taninjs/ESP32-STPM10/PCBs/Infrared/Infrared.step

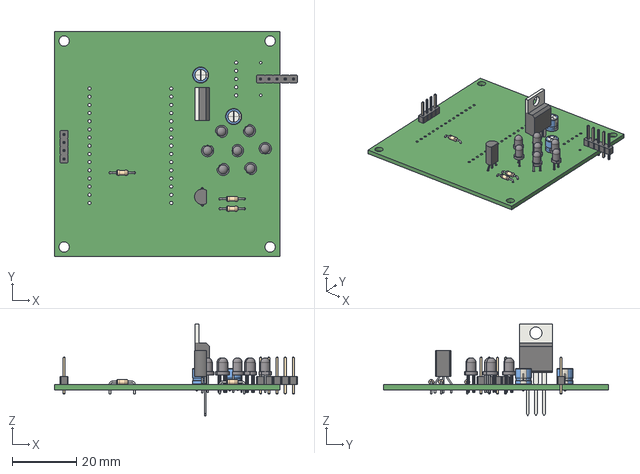
[picture p1: CAD file, 2019-03-27]
PCBs/Infrared/Infrared.step
75.5 x 70.0 x 28.5 mm
