taninjs/ESP32-STPM10/PCBs/Layer2/Display.step

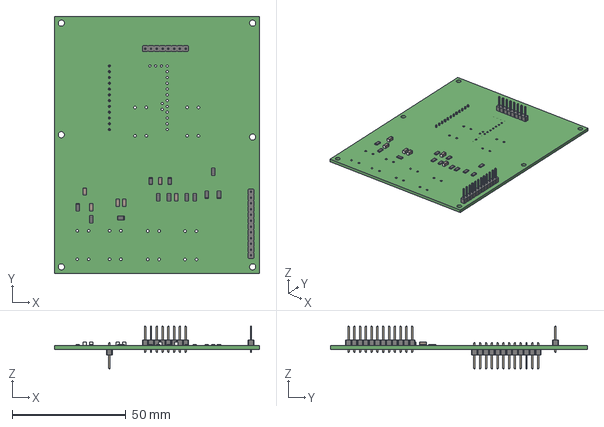
[picture p2: CAD file, 2019-03-27]
PCBs/Layer2/Display.step
90.0 x 113.0 x 18.8 mm
