taninjs/ESP32-STPM10/PCBs/docs/layer1-schematics.pdf

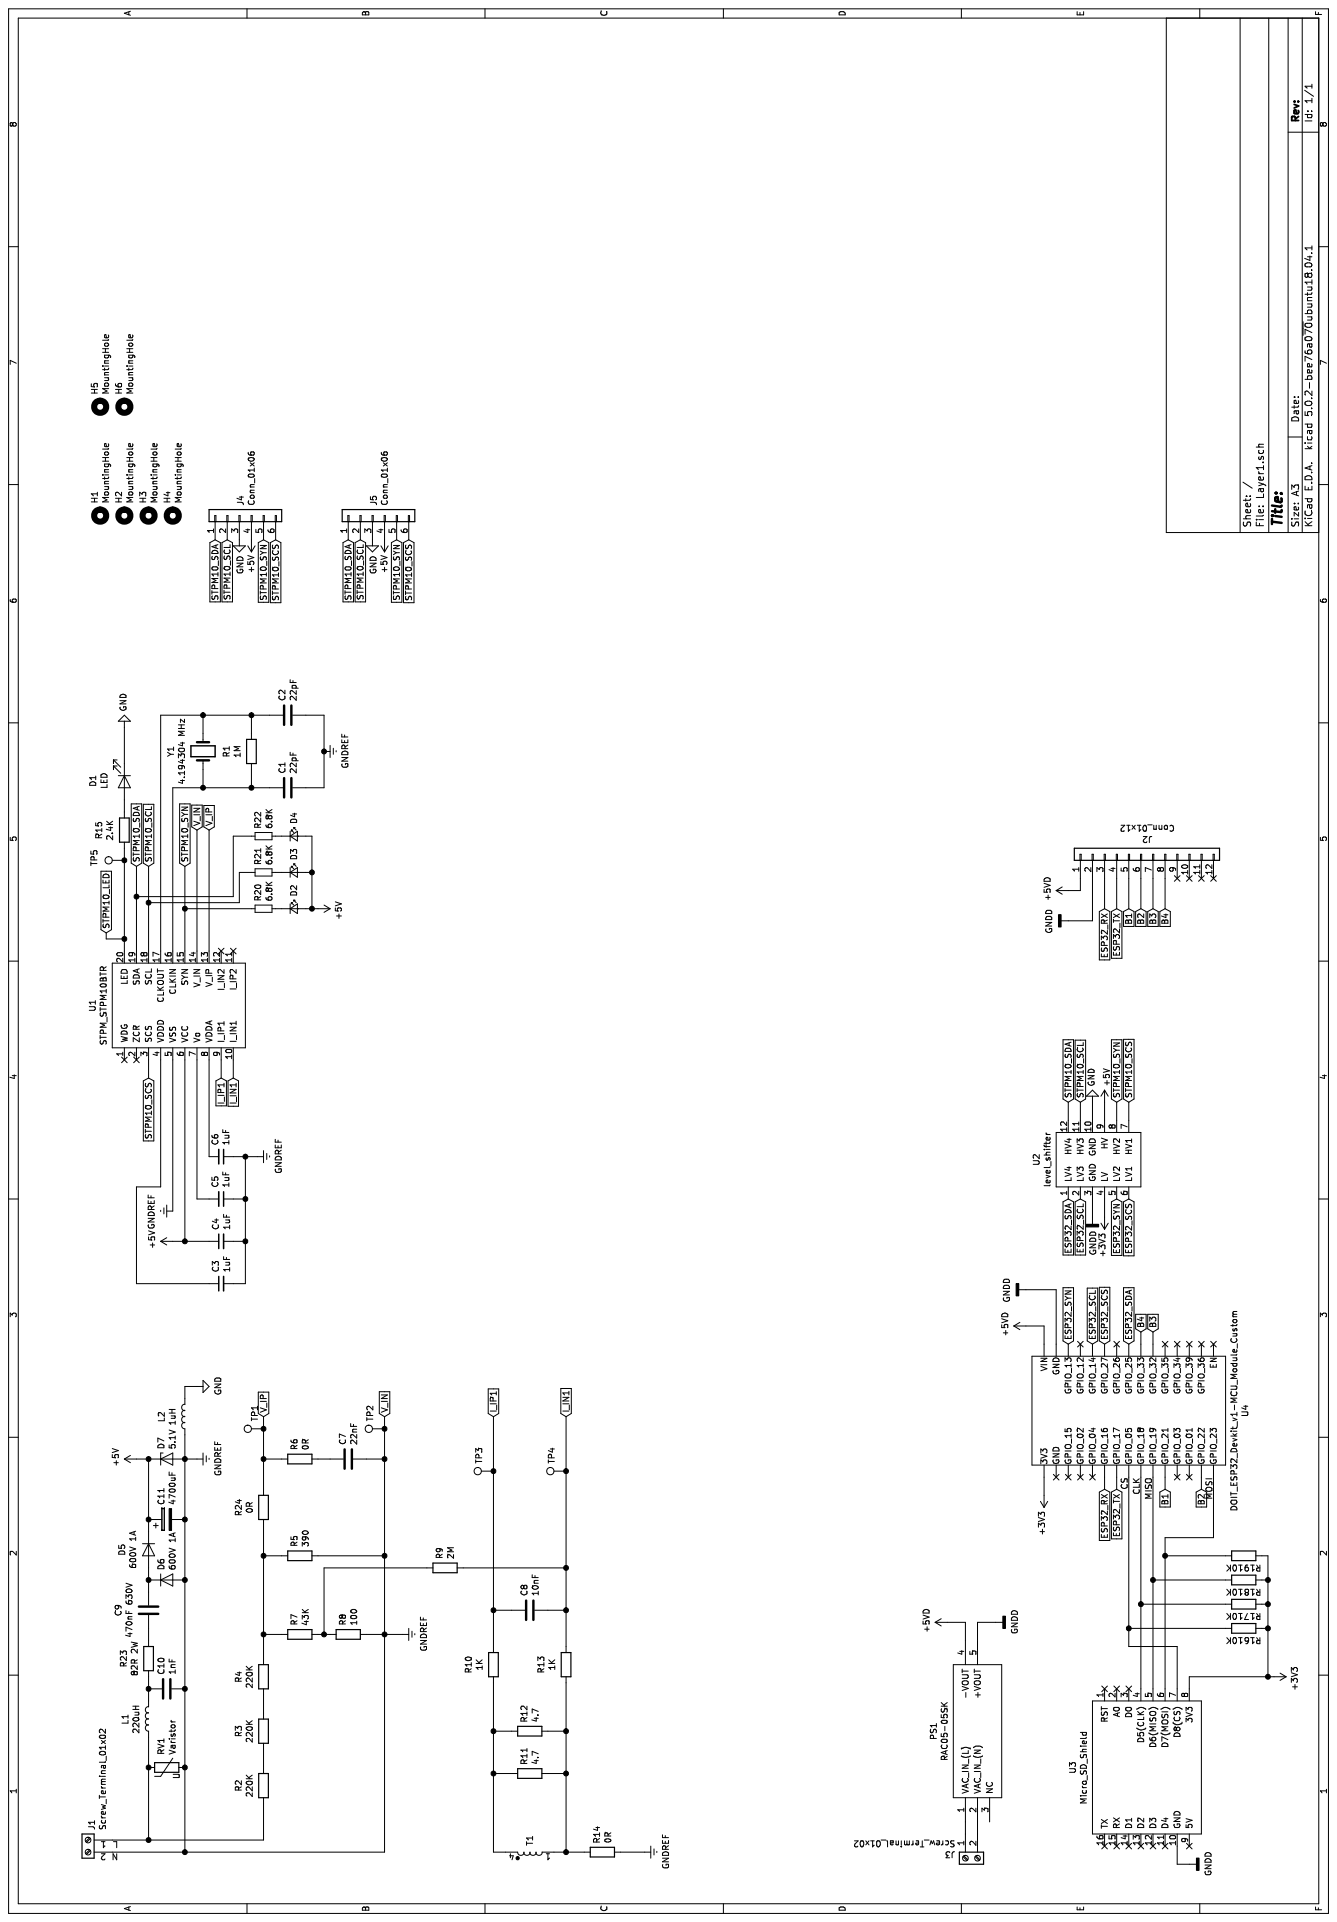
[picture p3: page 1]
