taninjs/ESP32-STPM10/PCBs/Layer1/Layer1.pdf

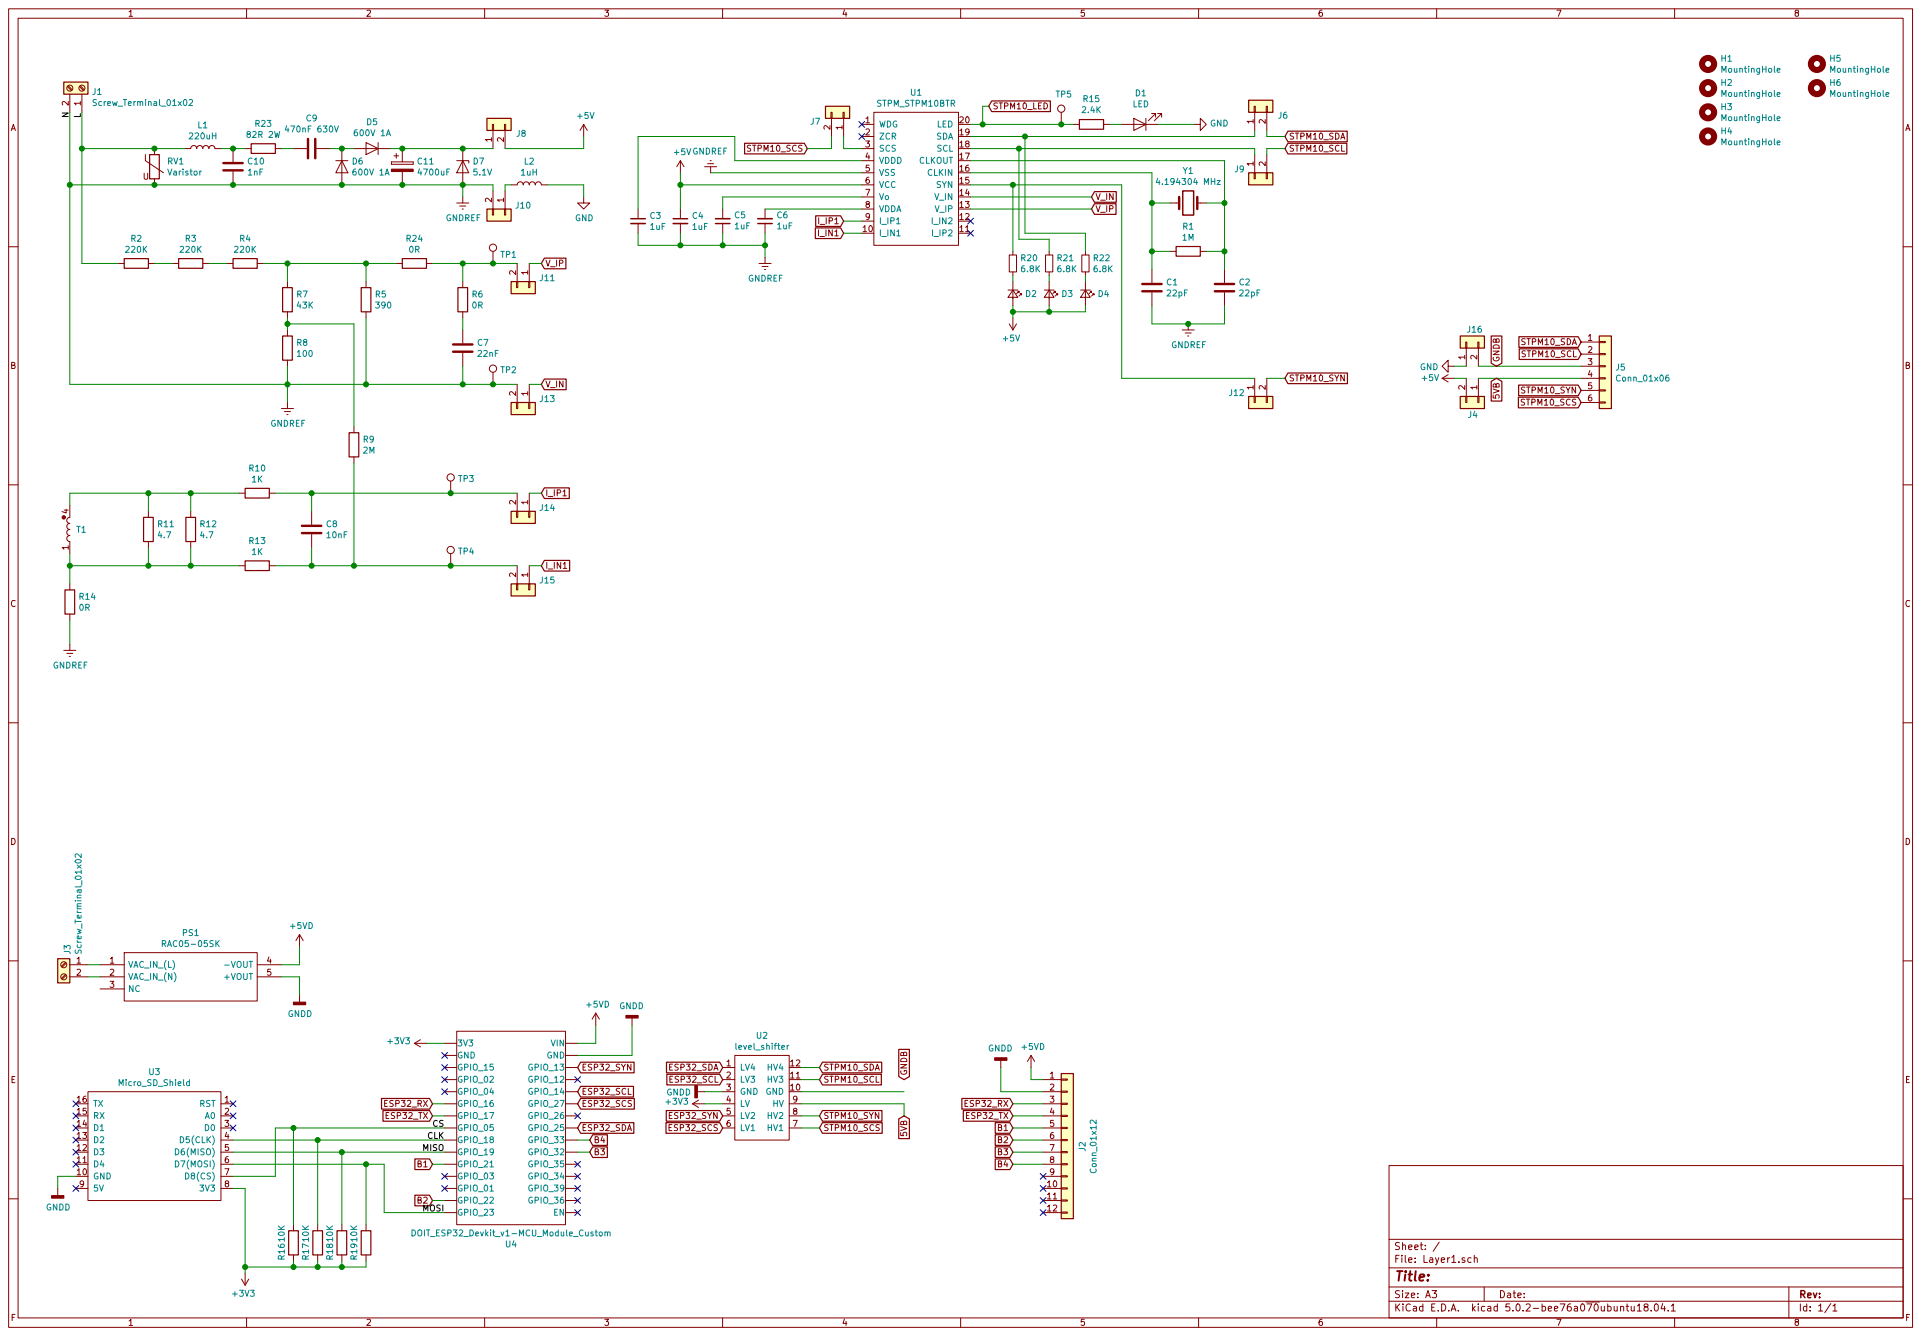
[picture p4: page 1]
