taninjs/ESP32-STPM10/PCBs/Infrared/Infrared.pdf

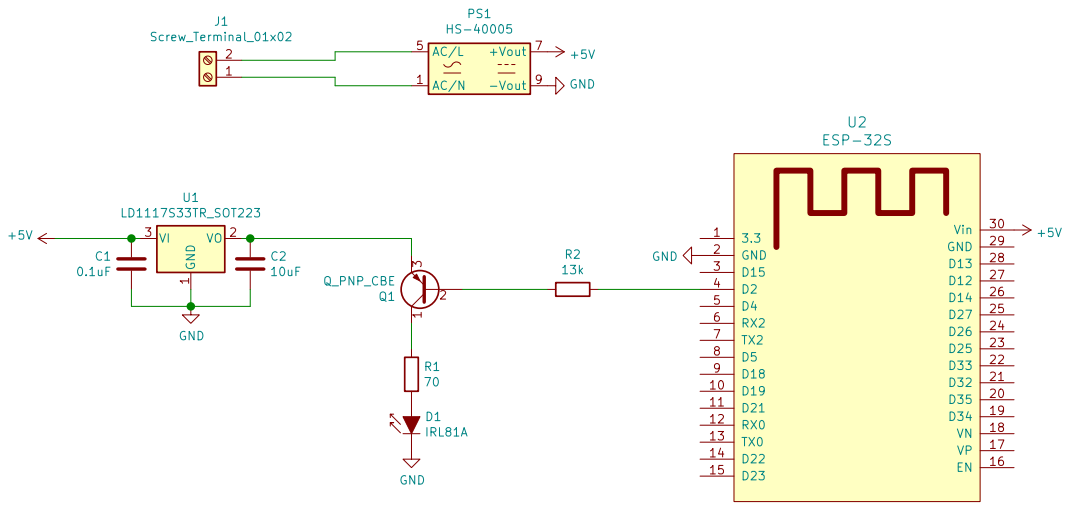
[picture p5: page 1]

Id: 1/1 Title: File: Infrared.sch Sheet: /
