taninjs/ESP32-STPM10/PCBs/Layer1/Layer1.kicad_pcb

## KiCad design PCBs/Layer1/Layer1.kicad_pcb (2019-04-03)

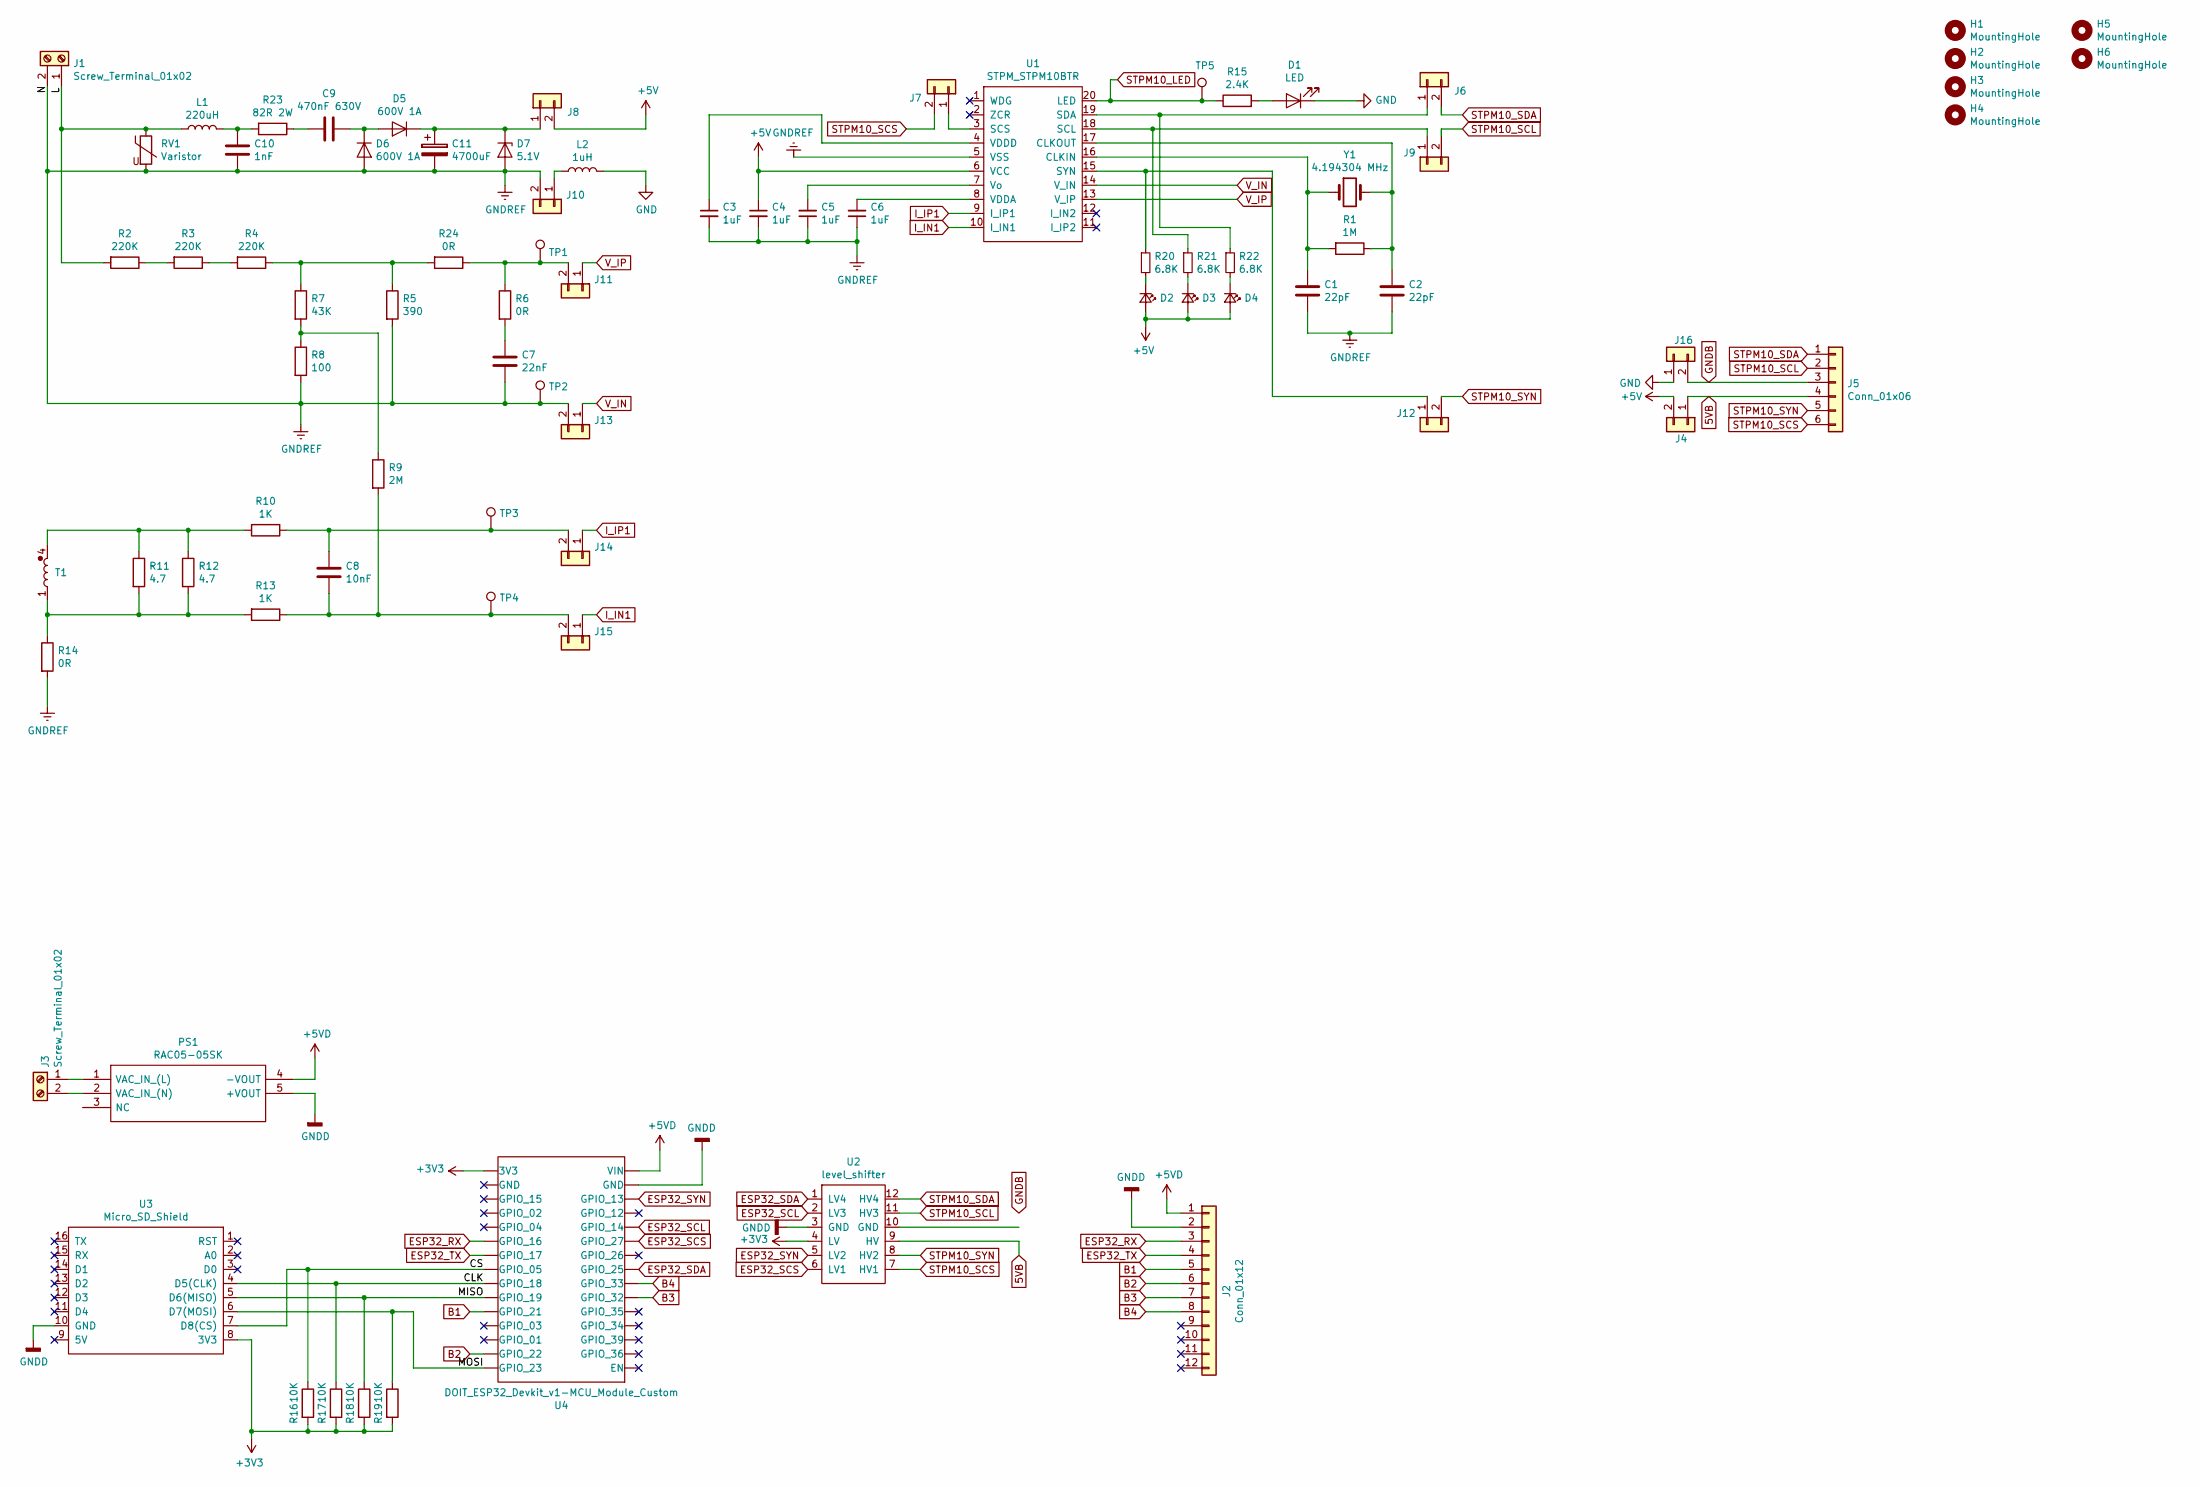
[picture p6: schematic Layer1.sch]

Parts:
C1, C2: 22pF; C_1206_3216Metric_Pad1.42x1.75mm_HandSolder
C3, C4, C5, C6: 1uF; C_0603_1608Metric_Pad1.05x0.95mm_HandSolder
C7: 22nF; C_1206_3216Metric_Pad1.42x1.75mm_HandSolder
C8: 10nF; C_1206_3216Metric_Pad1.42x1.75mm_HandSolder
C9: 470nF 630V; C_Rect_L26.5mm_W15.5mm_P22.50mm_MKS4
C10: 1nF; C_1806_4516Metric_Pad1.57x1.80mm_HandSolder
C11: 4700uF; CP_Radial_D12.5mm_P5.00mm
D1: LED; LED_0603_1608Metric_Pad1.05x0.95mm_HandSolder
D2, D3, D4: LED_Small; LED_0603_1608Metric_Pad1.05x0.95mm_HandSolder
D5, D6: 600V 1A; D_SMA_Handsoldering
D7: 5.1V; SOD-80
H1, H2, H3, H4, H5, H6: MountingHole; MountingHole_2.7mm_M2.5_DIN965
J1, J3: Screw_Terminal_01x02; TerminalBlock_bornier-2_P5.08mm
J2: Conn_01x12; JST_PH_B12B-PH-K_1x12_P2.00mm_Vertical
J4, J6, J7, J8, J9, J10, J11, J12, J13, J14, J15, J16: Conn_01x02; PinHeader_1x02_P2.54mm_Vertical
J5: Conn_01x06; PinHeader_1x06_P2.54mm_Vertical
L1: 220uH; L_1812_4532Metric_Pad1.30x3.40mm_HandSolder
L2: 1uH; L_1812_4532Metric_Pad1.30x3.40mm_HandSolder
PS1: RAC05-05SK; RAC05-12SK; Manufacturer_Part_Number RAC05-05SK; Mouser Part Number 919-RAC05-05SK
R1: 1M; R_1206_3216Metric_Pad1.42x1.75mm_HandSolder
R2, R3, R4: 220K; R_1206_3216Metric_Pad1.42x1.75mm_HandSolder
R5: 390; R_1206_3216Metric_Pad1.42x1.75mm_HandSolder
R6, R14, R24: 0R; R_1206_3216Metric_Pad1.42x1.75mm_HandSolder
R7: 43K; R_1206_3216Metric_Pad1.42x1.75mm_HandSolder
R8: 100; R_1206_3216Metric_Pad1.42x1.75mm_HandSolder
R9: 2M; R_Axial_DIN0204_L3.6mm_D1.6mm_P5.08mm_Horizontal
R10, R13: 1K; R_1206_3216Metric_Pad1.42x1.75mm_HandSolder
R11, R12: 4.7; R_1206_3216Metric_Pad1.42x1.75mm_HandSolder
R15: 2.4K; R_0603_1608Metric_Pad1.05x0.95mm_HandSolder
R16, R17, R18, R19: 10K; R_Axial_DIN0204_L3.6mm_D1.6mm_P5.08mm_Horizontal
R20, R21, R22: 6.8K; R_0603_1608Metric_Pad1.05x0.95mm_HandSolder
R23: 82R 2W; R_Axial_DIN0617_L17.0mm_D6.0mm_P20.32mm_Horizontal
RV1: Varistor; RV_Disc_D15.5mm_W5.9mm_P7.5mm
T1: T60404-E4624-X501
TP1, TP2, TP3, TP4, TP5: TestPoint; TestPoint_THTPad_2.0x2.0mm_Drill1.0mm
U1: STPM_STPM10BTR; TSSOP-20_4.4x6.5mm_P0.65mm
U2: level_shifter; levelshiter
U3: Micro_SD_Shield; sdcard
U4: DOIT_ESP32_Devkit_v1-MCU_Module_Custom; ESP32_DOIT_v1
Y1: 4.194304 MHz; Crystal_HC18-U_Vertical

Connections:
5VB: J4.1, J5.4, U2.9 (HV)
+3V3: R16.2, R17.2, R18.2, R19.2, U2.4 (LV), U3.8 (3V3), U4.16 (3V3)
+5V: C4.1, D2.2 (A), D3.2 (A), D4.2 (A), J4.2, J8.2, U1.6 (VCC)
+5VD: J2.1, PS1.4 (-VOUT), U4.15 (VIN)
/CLK: R17.1, U3.4 (D5(CLK)), U4.24 (GPIO_18)
/CS: R16.1, U3.7 (D8(CS)), U4.23 (GPIO_05)
/L: J1.1, L1.1, R2.2, RV1.1
/MISO: R18.1, U3.5 (D6(MISO)), U4.25 (GPIO_19)
/MOSI: R19.1, U3.6 (D7(MOSI)), U4.30 (GPIO_23)
B1: J2.5, U4.26 (GPIO_21)
B2: J2.6, U4.29 (GPIO_22)
B3: J2.7, U4.6 (GPIO_32)
B4: J2.8, U4.7 (GPIO_33)
ESP32_RX: J2.3, U4.21 (GPIO_16)
ESP32_SCL: U2.2 (LV3), U4.11 (GPIO_14)
ESP32_SCS: U2.6 (LV1), U4.10 (GPIO_27)
ESP32_SDA: U2.1 (LV4), U4.8 (GPIO_25)
ESP32_SYN: U2.5 (LV2), U4.13 (GPIO_13)
ESP32_TX: J2.4, U4.22 (GPIO_17)
GND: D1.1 (K), J16.1, L2.2
GNDB: J5.3, J16.2
GNDD: J2.2, PS1.5 (+VOUT), U2.3 (GND), U3.10 (GND), U4.14 (GND)
GNDREF: C1.2, C2.2, C3.2, C4.2, C5.1, C6.1, C7.2, C10.2, C11.2, D6.2 (A), D7.2 (A), J1.2, J10.2, J13.2, R5.2, R8.2, R14.2, RV1.2, TP2.1, U1.5 (VSS)
I_IN1: J15.1, U1.10 (I_IN1)
I_IP1: J14.1, U1.9 (I_IP1)
unnamed: C1.1, R1.2, U1.16 (CLKIN), Y1.1
unnamed: C2.1, R1.1, U1.17 (CLKOUT), Y1.2
unnamed: C3.1, U1.4 (VDDD)
unnamed: C5.2, U1.7 (Vo)
unnamed: C6.2, U1.8 (VDDA)
unnamed: C7.1, R6.2
unnamed: C8.1, J14.2, R10.1, TP3.1
unnamed: C8.2, J15.2, R9.2, R13.1, TP4.1
unnamed: C9.1, D5.2 (A), D6.1 (K)
unnamed: C9.2, R23.1
unnamed: C10.1, L1.2, R23.2
unnamed: C11.1, D5.1 (K), D7.1 (K), J8.1
unnamed: D1.2 (A), R15.2
unnamed: D2.1 (K), R20.2
unnamed: D3.1 (K), R21.2
unnamed: D4.1 (K), R22.2
unnamed: J3.1, PS1.1 (VAC_IN_(L))
unnamed: J3.2, PS1.2 (VAC_IN_(N))
unnamed: J6.1, R22.1, U1.19 (SDA)
unnamed: J7.1, U1.3 (SCS)
unnamed: J9.1, R21.1, U1.18 (SCL)
unnamed: J10.1, L2.1
unnamed: J11.2, R6.1, R24.1, TP1.1
unnamed: J12.1, R20.1, U1.15 (SYN)
unnamed: R2.1, R3.2
unnamed: R3.1, R4.2
unnamed: R7.2, R8.1, R9.1
unnamed: R10.2, R11.1, R12.1, T1.4
unnamed: R11.2, R12.2, R13.2, R14.1, T1.1
unnamed: R4.1, R5.1, R7.1, R24.2
STPM10_LED: R15.1, TP5.1, U1.20 (LED)
STPM10_SCL: J5.2, J9.2, U2.11 (HV3)
STPM10_SCS: J5.6, J7.2, U2.7 (HV1)
STPM10_SDA: J5.1, J6.2, U2.12 (HV4)
STPM10_SYN: J5.5, J12.2, U2.8 (HV2)
V_IN: J13.1, U1.14 (V_IN)
V_IP: J11.1, U1.13 (V_IP)

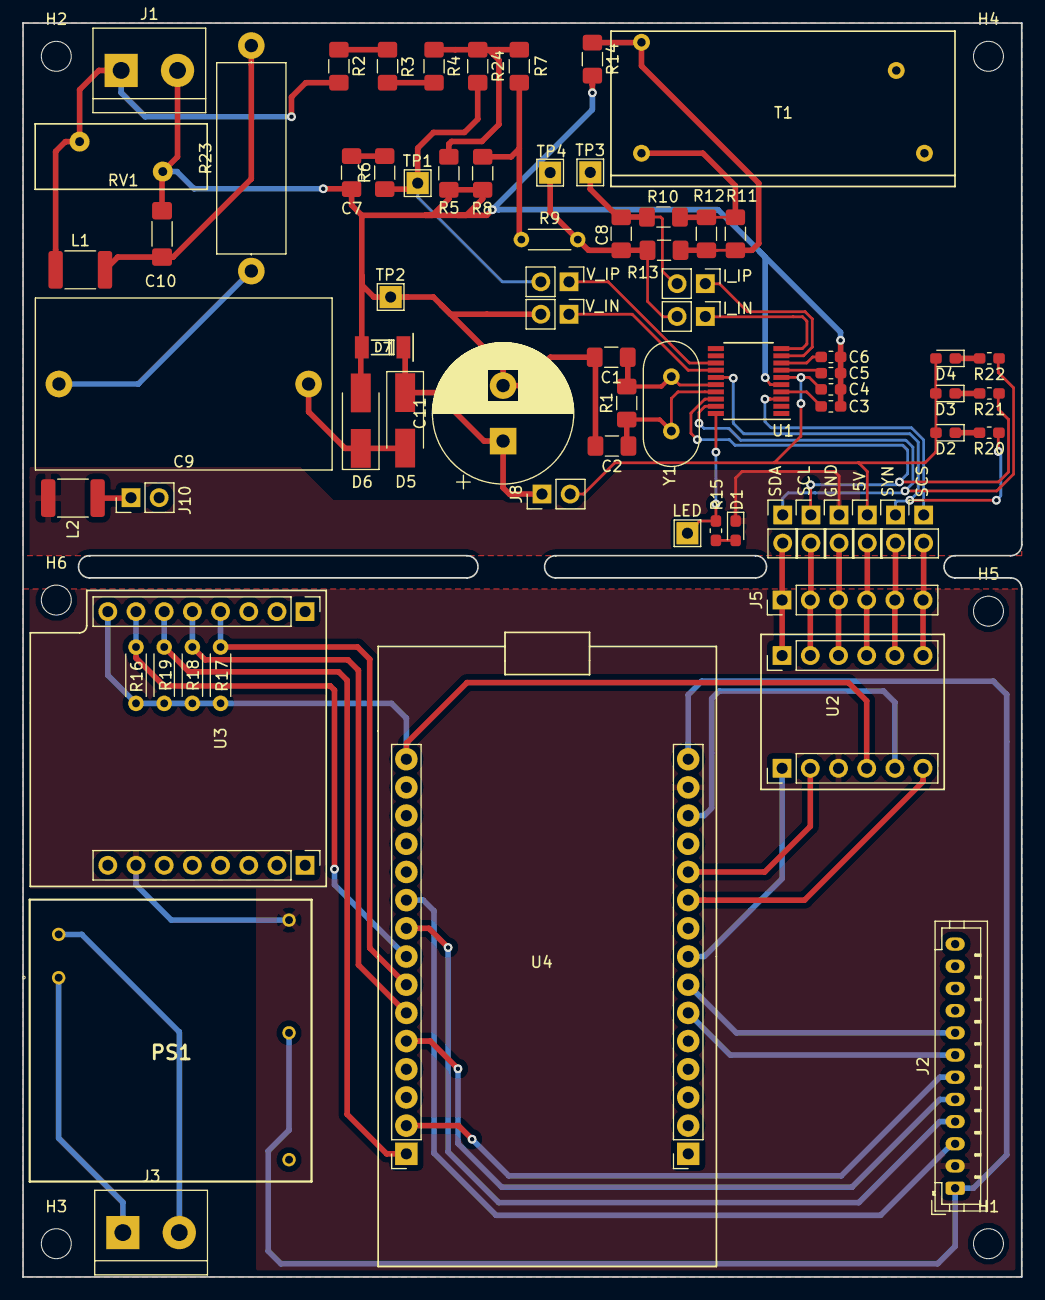
[picture p7: board Layer1.kicad_pcb from above]

Board: 2 copper layers, 90.0 x 113.0 mm, 79 parts (0 on the bottom side), 62 nets.
