taninjs/ESP32-STPM10/PCBs/Layer2/Display.kicad_pcb

## KiCad design PCBs/Layer2/Display.kicad_pcb (2019-03-27)

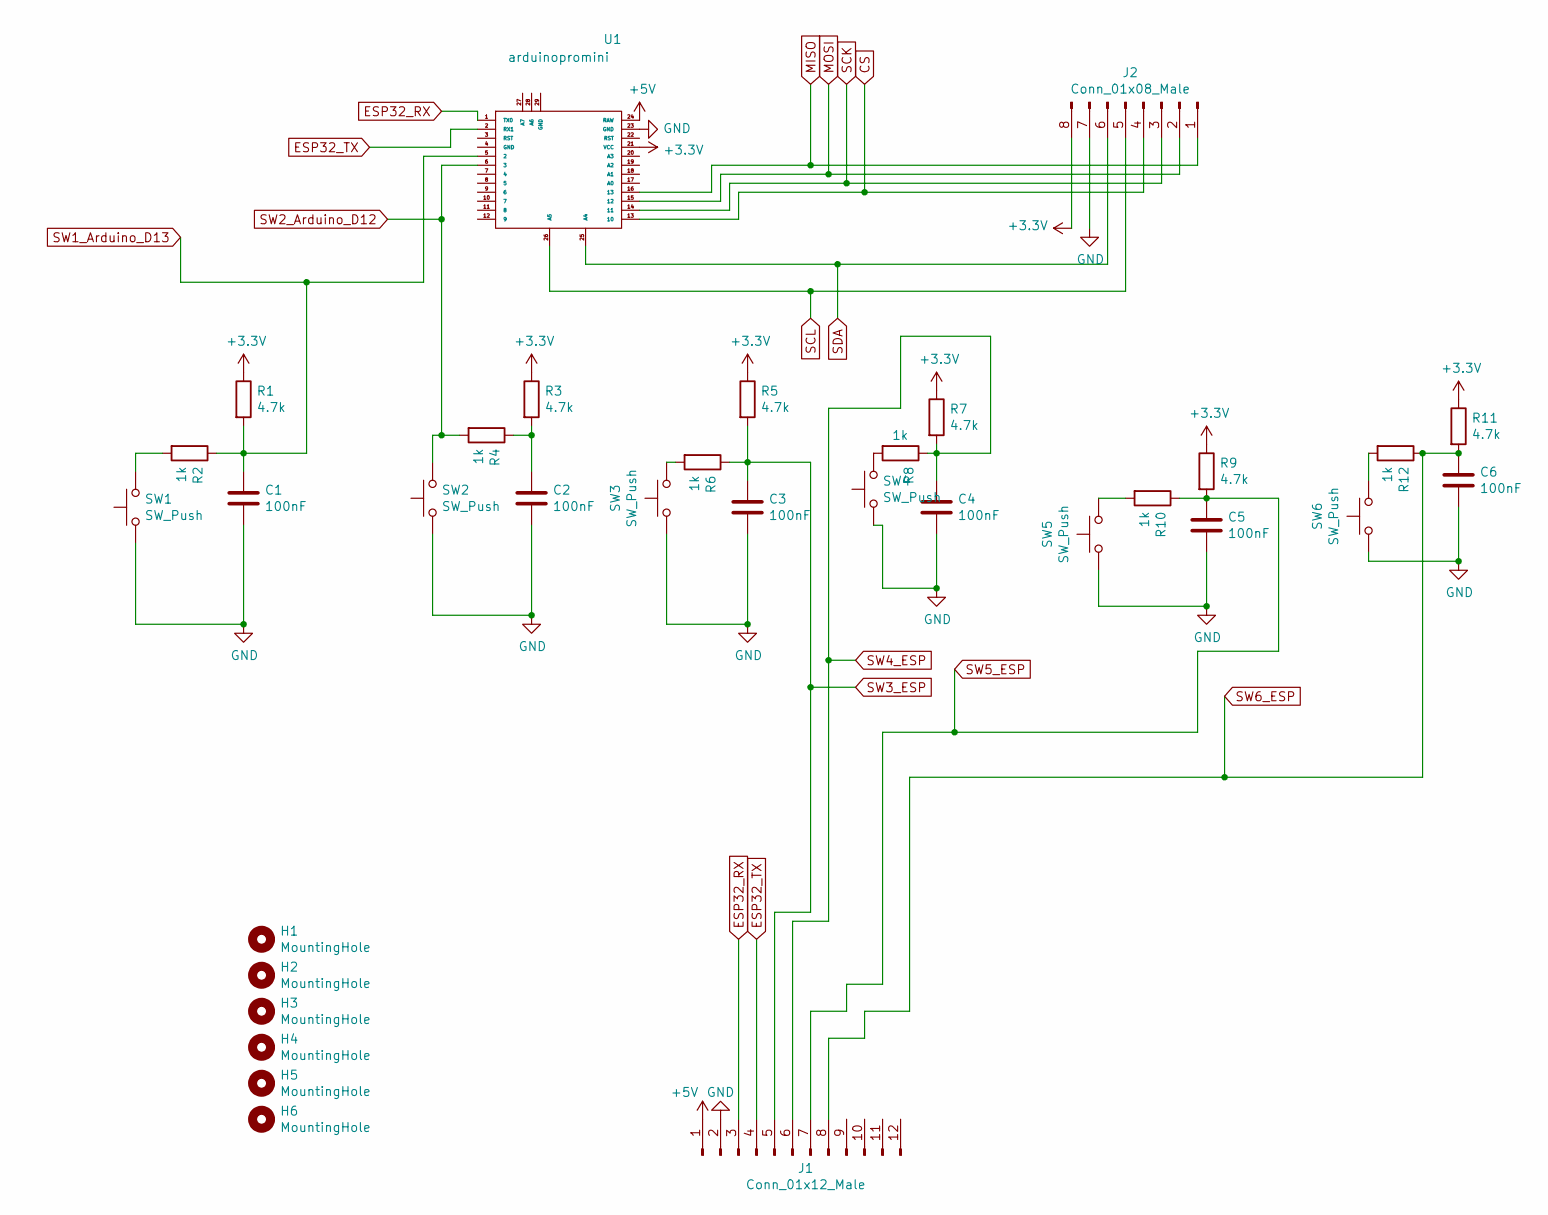
[picture p8: schematic Display.sch]

Parts:
C1, C2, C3, C4, C5, C6: 100nF; C_1206_3216Metric_Pad1.42x1.75mm_HandSolder
H1, H2, H3, H4, H5, H6: MountingHole; MountingHole_2.7mm_M2.5_DIN965
J1: Conn_01x12_Male; PinHeader_1x12_P2.54mm_Vertical
J2: Conn_01x08_Male; PinHeader_1x08_P2.54mm_Vertical
R1, R3, R5, R7, R9, R11: 4.7k; R_1206_3216Metric_Pad1.42x1.75mm_HandSolder
R2, R4, R6, R8, R10, R12: 1k; R_1206_3216Metric_Pad1.42x1.75mm_HandSolder
SW1, SW2, SW3, SW4, SW5, SW6: SW_Push; SW_PUSH-12mm_Wuerth-430476085716
U1: arduinopromini

Connections:
+3V3: J2.8, R1.1, R3.1, R5.1, R7.1, R9.1, R11.1, U1.21 (VCC)
+5V: J1.1, U1.24 (RAW)
CS: J2.4, U1.13 (10)
ESP32_RX: J1.3, U1.1 (TX0)
ESP32_TX: J1.4, U1.2 (RX1)
GND: C1.2, C2.2, C3.2, C4.2, C5.2, C6.2, J1.2, J2.7, SW1.1, SW2.1, SW3.1, SW4.1, SW5.1, SW6.1, U1.23 (GND)
MISO: J2.1, U1.16 (13)
MOSI: J2.2, U1.15 (12)
unnamed: C2.1, R3.2, R4.1
unnamed: R2.2, SW1.2
unnamed: R6.2, SW3.2
unnamed: R8.2, SW4.2
unnamed: R10.2, SW5.2
unnamed: R12.2, SW6.2
SCK: J2.3, U1.14 (11)
SCL: J2.5, U1.26 (A5)
SDA: J2.6, U1.25 (A4)
SW1_Arduino_D13: C1.1, R1.2, R2.1, U1.5 (2)
SW2_Arduino_D12: R4.2, SW2.2, U1.6 (3)
SW3_ESP: C3.1, J1.5, R5.2, R6.1
SW4_ESP: C4.1, J1.6, R7.2, R8.1
SW5_ESP: C5.1, J1.7, R9.2, R10.1
SW6_ESP: C6.1, J1.8, R11.2, R12.1

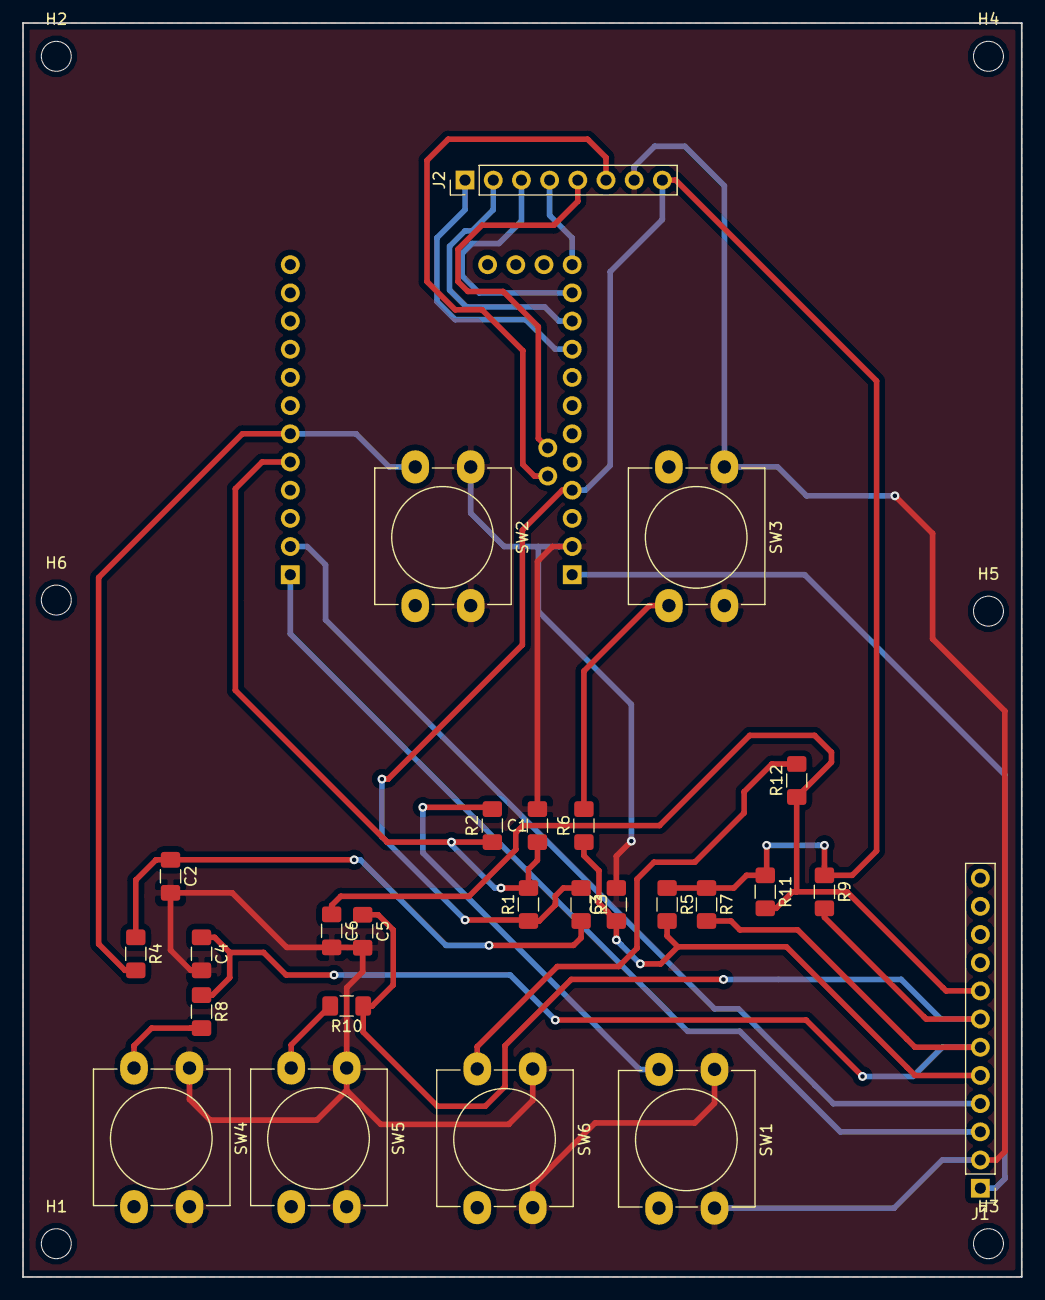
[picture p9: board Display.kicad_pcb from above]

Board: 2 copper layers, 90.0 x 113.0 mm, 33 parts (1 on the bottom side), 23 nets.
