taninjs/ESP32-STPM10/PCBs/Infrared/Infrared.kicad_pcb

## KiCad design PCBs/Infrared/Infrared.kicad_pcb (2019-03-18)

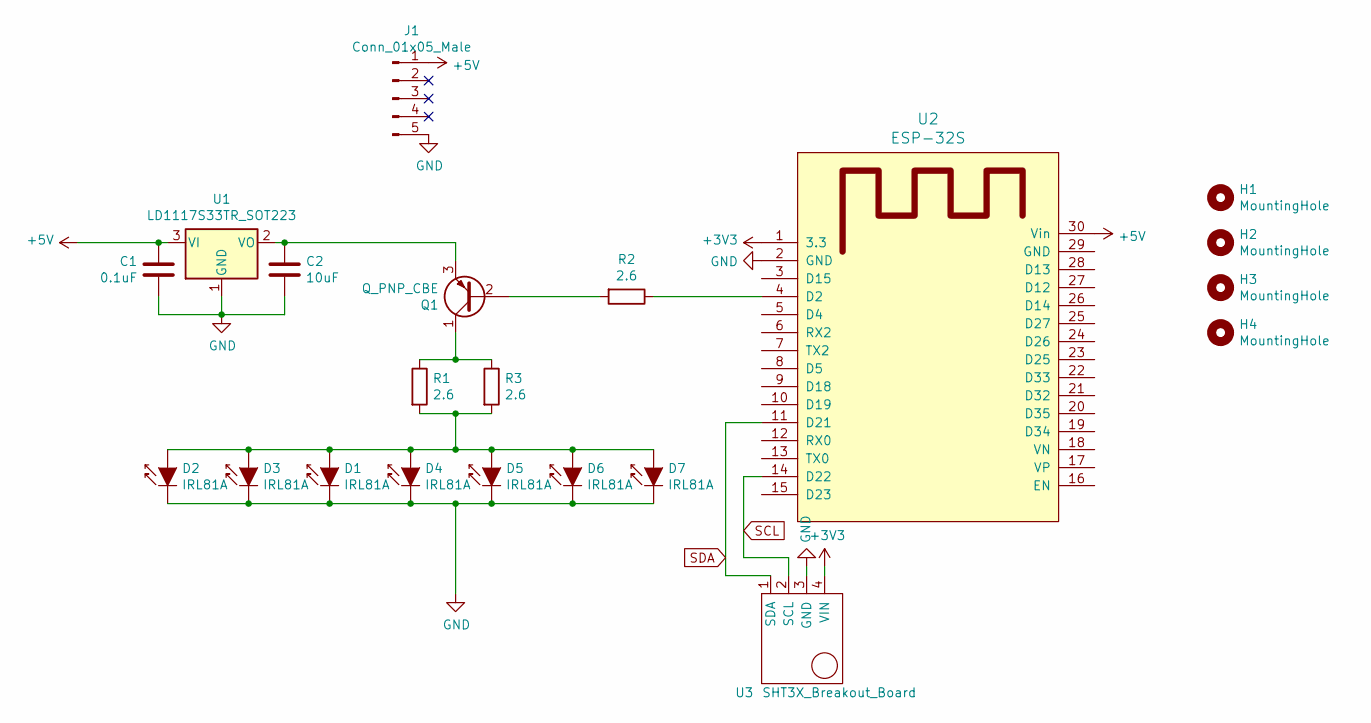
[picture p10: schematic Infrared.sch]

Parts:
C1: 0.1uF; CP_Radial_D5.0mm_P2.50mm
C2: 10uF; CP_Radial_D5.0mm_P2.50mm
D1, D2, D3, D4, D5, D6, D7: IRL81A; LED_D3.0mm_IRGrey
H1, H2, H3, H4: MountingHole; MountingHole_3.2mm_M3_DIN965
J1: Conn_01x05_Male; PinHeader_1x05_P2.54mm_Vertical
Q1: Q_PNP_CBE; TO-92L_Inline_Wide
R1, R2, R3: 2.6; R_Axial_DIN0204_L3.6mm_D1.6mm_P7.62mm_Horizontal
U1: LD1117S33TR_SOT223; TO-220-3_Vertical
U2: ESP-32S; ESP32_DOIT_v1
U3: SHT3X_Breakout_Board; PinHeader_1x04_P2.54mm_Vertical

Connections:
+3V3: U2.1 (3.3), U3.4 (VIN)
+5V: C1.1, J1.1, U1.3 (VI), U2.30 (Vin)
GND: C1.2, C2.2, D1.1 (K), D2.1 (K), D3.1 (K), D4.1 (K), D5.1 (K), D6.1 (K), D7.1 (K), J1.5, U1.1 (GND), U2.2 (GND), U3.3 (GND)
unnamed: C2.1, Q1.3 (E), U1.2 (VO)
unnamed: D1.2 (A), D2.2 (A), D3.2 (A), D4.2 (A), D5.2 (A), D6.2 (A), D7.2 (A), R1.2, R3.2
unnamed: Q1.1 (C), R1.1, R3.1
unnamed: Q1.2 (B), R2.2
unnamed: R2.1, U2.4 (D2)
SCL: U2.14 (D22), U3.2 (SCL)
SDA: U2.11 (D21), U3.1 (SDA)

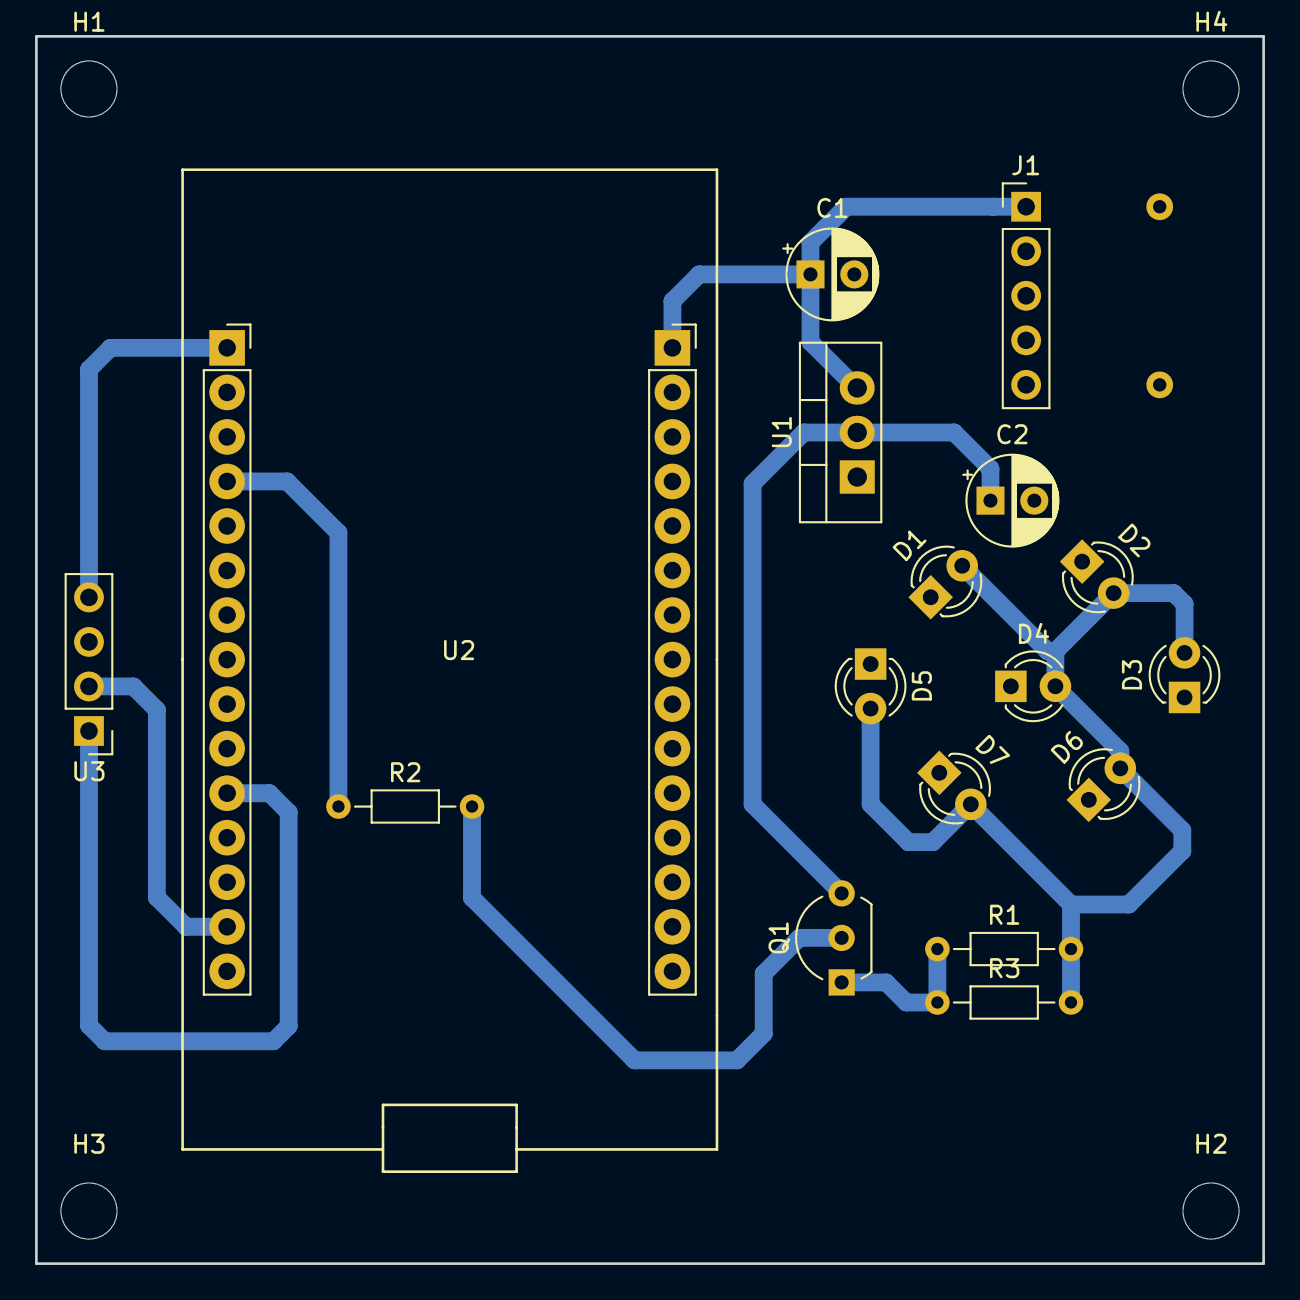
[picture p11: board Infrared.kicad_pcb from above]

Board: 2 copper layers, 70.0 x 70.0 mm, 21 parts (0 on the bottom side), 10 nets.
