taninjs/ESP32-STPM10/(commit log)

2019-02-11 Add PCBs
    [Control.kicad_pcb, Control.sch, Meter.kicad_pcb, Meter.sch, STPM10 Energy Metering Circuit.sch]
2019-03-09 Add sd card
    [Control.sch]
2019-03-10 Add ESP32 footprint
2019-03-10 add layer 1 project
    [Control.sch, Layer1.kicad_pcb, Layer1.sch, Meter.kicad_pcb, Meter.sch, STPM10 Energy Metering Circuit.sch]
2019-03-10 add arduino level shifter sd card footprint
2019-03-10 add arduino levelshifter sd card symbol
2019-03-10 add power supply RAC05-05SK lib, footprint
2019-03-10 update esp32, sd-card-shield, levelshifter footprint
2019-03-10 Layer1 Ver1.0
    [Layer1.kicad_pcb, Layer1.sch]
2019-03-10 add layer 2
    [Display.kicad_pcb, Display.sch]
2019-03-16 WIP: version 2
    [Layer1.kicad_pcb, Layer1.sch]
2019-03-16 WIP: version 2 schematics
    [Layer1.csv, Layer1.kicad_pcb, Layer1.sch]
2019-03-18 Layer 1 Ver2, waiting for review
    [Layer1.kicad_pcb, Layer1.sch]
2019-03-18 add infrared project
    [Display.kicad_pcb, Display.sch]
2019-03-18 Auto stash before merge of "master" and "origin/master"
    [Infrared.kicad_pcb, Infrared.sch, Infrared.step]
2019-03-18 Infared PCB
    [Infrared.kicad_pcb, Infrared.sch, Infrared.step]
2019-03-18 display update
    [Display.kicad_pcb, Display.sch]
2019-03-18 layer 2 update
    [Display.kicad_pcb, Infrared.kicad_pcb, Infrared.sch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]
2019-03-19 WIP add pinheader
    [Layer1.kicad_pcb, Layer1.sch]
2019-03-19 Layer1 -- Ready to order
    [Layer1-B.Cu.gbr, Layer1-B.Mask.gbr, Layer1-B.Paste.gbr, Layer1-B.SilkS.gbr, Layer1-Edge.Cuts.gbr, Layer1-F.Cu.gbr, Layer1-F.Mask.gbr, Layer1-F.Paste.gbr]
2019-04-03 update PCB Layer1
    [Layer1-B.Cu.gbr, Layer1-B.Mask.gbr, Layer1-B.Paste.gbr, Layer1-B.SilkS.gbr, Layer1-Edge.Cuts.gbr, Layer1-F.Cu.gbr, Layer1-F.Mask.gbr, Layer1-F.Paste.gbr]
2019-04-03 minor change for esp32 code
2019-04-04 WIP: for calibration
